berezovskyi/kistarfid/report/title.tex

\begin{titlepage}
\begin{center}
\setcounter{page}{0}
\Huge \doctitle\\[0.3cm]
\large \docauthor\\
\normalsize \today
\\[2cm]
%\Huge\color{red} DARFT
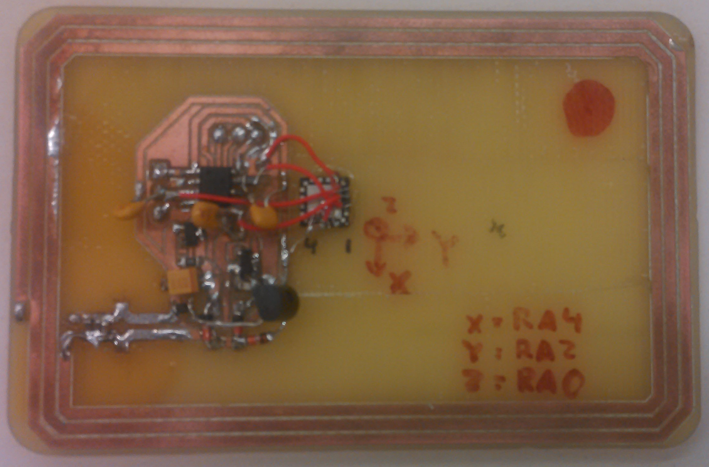
[picture p1: report/res/tag.jpg]

\end{center}
\end{titlepage}
\normalsize
