berezovskyi/kistarfid/report/work.tex

\section{Work Distribution}
\begin{table}[h]
\centering
\begin{tabular}{| l | r |}
	\hline
	Task & Assigned \\\hline
	CRC generation & Steven Arnow, Andrew Berezovskyi \\ \hline
	Demo client GUI and RFID interface conversion & Steven Arnow \\ \hline
	Demo client data processing & Axel Isaksson \\ \hline
	ADC interfacing & Steven Arnow \\\hline
	
	PCB schematic and layout & Axel Isaksson \\\hline
	Command decoding code & Axel Isaksson, Andrew Berezovskyi \\\hline
	Response encoding code & Axel Isaksson \\\hline
	
	Report & Steven Arnow, Axel Isaksson \\ \hline
	Staring at the spec, trying to make any sense of it & Steven, Axel, Andrew \\ \hline
	
	\hline
\end{tabular}
\caption{Work distribution}
\label{tab:work}
\end{table}
