berezovskyi/kistarfid/project_plan/slides.md

Slides outline
==================

##SW

* osc
	- bump freq
	- use
* VREF
* DAC
* COMP
* TIMER
* CCP
* STATE MACHINE
* CRC
	- other poly
* Modulation
