berezovskyi/kistarfid/minutes/160920.md

Project start
========================================

Parts:

- PIC12LF1612-E/SN
- GDEP015OC1

Links:

- http://www.instructables.com/id/RFID-Emulator-How-to-Clone-RFID-Card-Tag-/?ALLSTEPS
- http://www.openpcd.org/OpenPCD_Passive_RFID_Project
- https://github.com/dpavlin/librfid
- http://colinkarpfinger.com/blog/2010/the-dropouts-guide-to-antenna-design/
