berezovskyi/kistarfid/report/res/TX.pdf

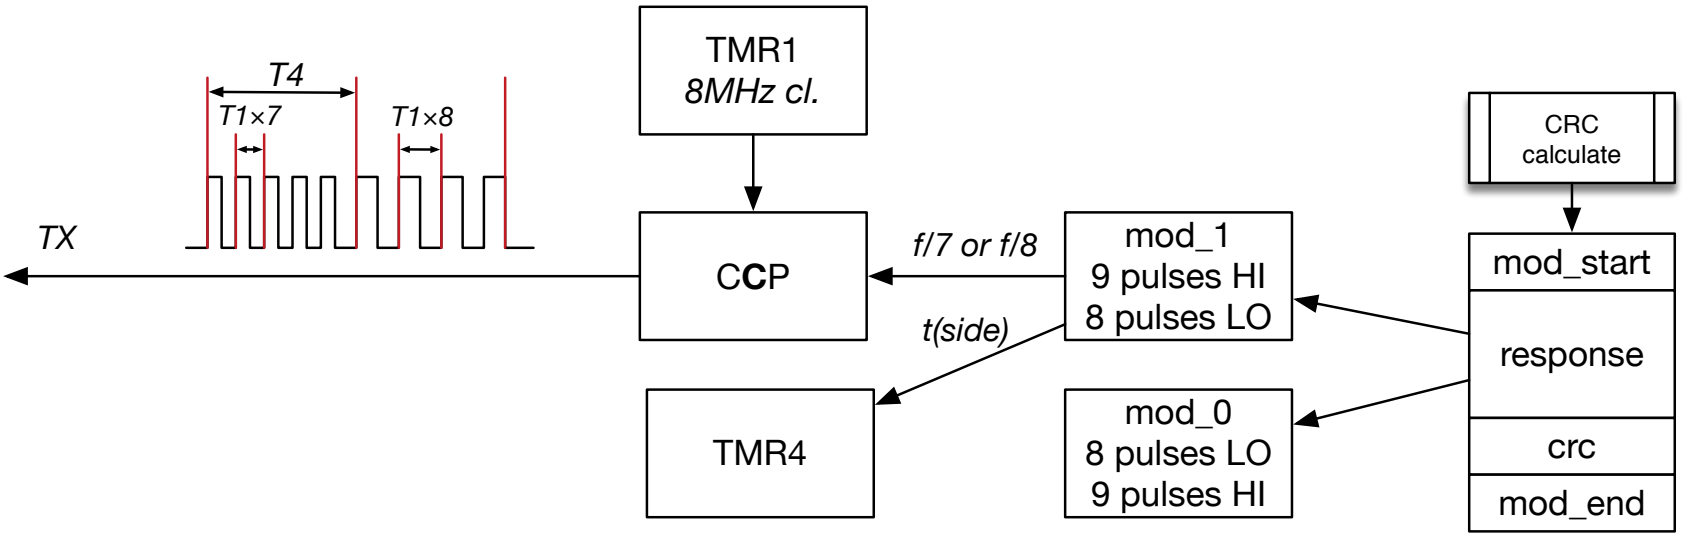
[picture p2: figure]
CRC calculate; mod_start; response; crc mod_end; mod_1 9 pulses HI 8 pulses LO; mod_0 8 pulses LO 9 pulses HI; TMR1 8MHz cl.; TMR4 CCP; t(side)
