berezovskyi/kistarfid/client/tag.png

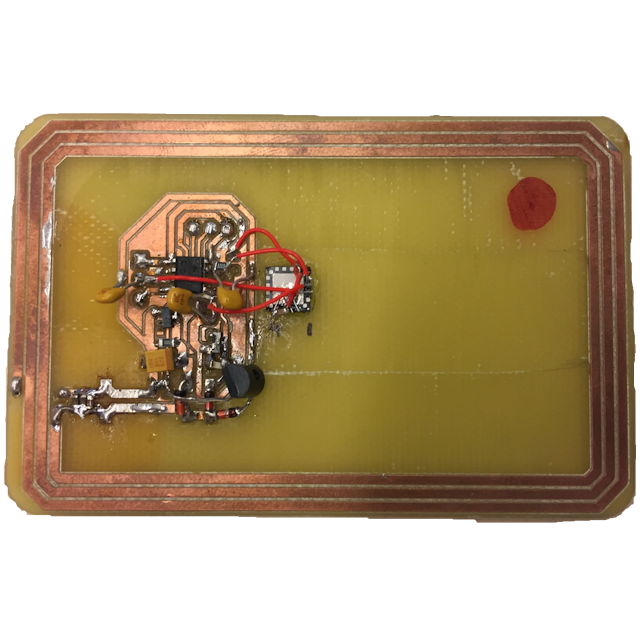
client/tag.png
