berezovskyi/kistarfid/report/res/RX.pdf

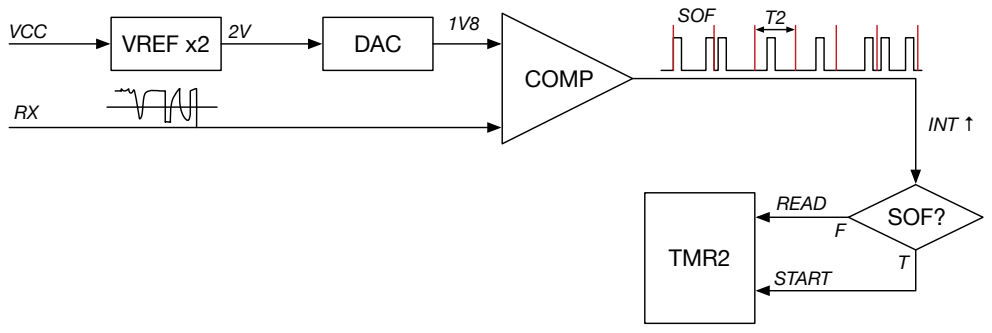
[picture p4: page 1]
VREF x2 VCC; DAC ²V; COMP; SOF?; SOF; TMR2; START; READ; INT
