berezovskyi/kistarfid/hw/softtag.kicad_pcb

## KiCad design hw/softtag.kicad_pcb (2016-10-04)

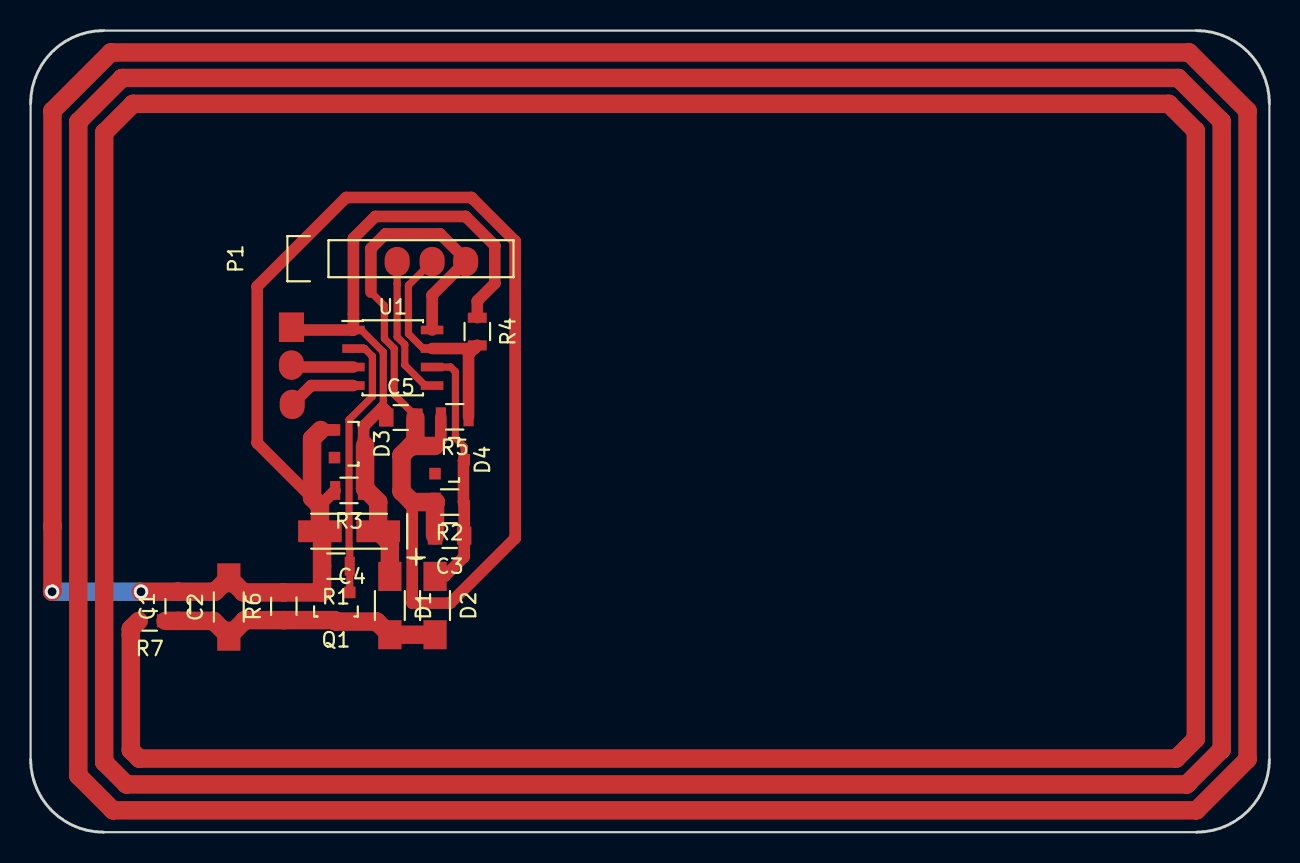
[picture p5: board softtag.kicad_pcb from above]

Board: 2 copper layers, 85.0 x 55.0 mm, 19 parts (0 on the bottom side), 9 nets.

Parts:
C1, C3, C5: C; C_0805
C2: CTRIM; C_1206_HandSoldering
C4: CP; TantalC_SizeA_EIA-3216_HandSoldering
D1: D_Schottky; C_1206_HandSoldering
D2: D; C_1206_HandSoldering
D3, D4: ZENER; SOT-23
P1: CONN_01X06; Pin_Header_Straight_1x06
Q1: Q_NMOS_GSD; SOT-23
R1, R2, R3, R4, R5, R6: R; R_0805
R7: 0R; R_0603
U1: PIC12LF1612-E/SN; SOIC-8_3.9x4.9mm_Pitch1.27mm

Connections:
/FREE0: P1.2, U1.3
/FREE1: P1.3, U1.4
/FREE2: P1.4, U1.5
/FREE3: P1.5, R4.2, R5.1, U1.7
/MOD_RX: C3.1, D2.1, D4.1, R2.1, U1.6
/MOD_TX: Q1.1, R1.1, U1.2
GND: C1.2, C2.2, C3.2, C4.2, C5.2, D3.2, D4.2, P1.6, Q1.2, R1.2, R2.2, R3.2, R5.2, R6.2, R7.2, U1.8
unnamed: C1.1, C2.1, D1.2, D2.2, Q1.3, R6.1, R7.1
VCC: C4.1, C5.1, D1.1, D3.1, P1.1, R3.1, R4.1, U1.1
