berezovskyi/kistarfid/sw/configuration_bits.c

/******************************************************************************/
/* Main Files to Include                                                      */
/******************************************************************************/

#if defined(__XC)
    #include <xc.h>         /* XC8 General Include File */
#elif defined(HI_TECH_C)
    #include <htc.h>        /* HiTech General Include File */
#endif

/******************************************************************************/
/* Configuration Bits                                                         */
/*                                                                            */
/* Refer to your Hi-Tech User Manual in the PICC installation directory       */
/* /doc folder for more information on filling in configuration bits.         */
/* In addition, configuration bit mnemonics can be found in your              */
/* PICC\version\include\<processor name>.h file for your device.  The XC8     */
/* compiler contains documentation on the configuration bit macros within     */
/* the compiler installation /docs folder in a file called                    */
/* pic18_chipinfo.html.                                                       */
/*                                                                            */
/* For additional information about what the hardware configurations mean in  */
/* terms of device operation, refer to the device datasheet.                  */
/*                                                                            */
/* A feature of MPLAB X is the 'Generate Source Code to Output' utility in    */
/* the Configuration Bits window.  Under Window > PIC Memory Views >          */
/* Configuration Bits, a user controllable configuration bits window is       */
/* available to Generate Configuration Bits source code which the user can    */
/* paste into this project.                                                   */
/*                                                                            */
/******************************************************************************/

/* TODO Fill in your config bits here.  Use the configuration bits generator. */


// PIC12LF1612 Configuration Bit Settings

// 'C' source line config statements

// CONFIG1
#pragma config FOSC = INTOSC    // Oscillator Selection Bits (INTOSC oscillator: I/O function on CLKIN pin)
#pragma config PWRTE = OFF      // Power-up Timer Enable (PWRT disabled)
#pragma config MCLRE = ON       // MCLR Pin Function Select (MCLR/VPP pin function is MCLR)
#pragma config CP = OFF         // Flash Program Memory Code Protection (Program memory code protection is disabled)
#pragma config BOREN = ON       // Brown-out Reset Enable (Brown-out Reset enabled)
#pragma config CLKOUTEN = ON    // Clock Out Enable (CLKOUT function is enabled on the CLKOUT pin)

// CONFIG2
#pragma config WRT = OFF        // Flash Memory Self-Write Protection (Write protection off)
#pragma config ZCD = OFF        // Zero Cross Detect Disable Bit (ZCD disable.  ZCD can be enabled by setting the ZCDSEN bit of ZCDCON)
#pragma config PLLEN = ON       // PLL Enable Bit (4x PLL is always enabled)
#pragma config STVREN = ON      // Stack Overflow/Underflow Reset Enable (Stack Overflow or Underflow will cause a Reset)
#pragma config BORV = LO        // Brown-out Reset Voltage Selection (Brown-out Reset Voltage (Vbor), low trip point selected.)
#pragma config LPBOR = OFF      // Low-Power Brown Out Reset (Low-Power BOR is disabled)
#pragma config LVP = ON         // Low-Voltage Programming Enable (Low-voltage programming enabled)

// CONFIG3
#pragma config WDTCPS = WDTCPS1F// WDT Period Select (Software Control (WDTPS))
#pragma config WDTE = OFF       // Watchdog Timer Enable (WDT disabled)
#pragma config WDTCWS = WDTCWSSW// WDT Window Select (Software WDT window size control (WDTWS bits))
#pragma config WDTCCS = SWC     // WDT Input Clock Selector (Software control, controlled by WDTCS bits)
