berezovskyi/kistarfid/sw/cmd.h

/* 
 * File:   cmd.h
 * Author: axel
 *
 * Created on October 26, 2016, 4:54 PM
 */

#ifndef CMD_H
#define	CMD_H

#ifdef	__cplusplus
extern "C" {
#endif

void cmd_inventory(void);
void cmd_read(void);


#ifdef	__cplusplus
}
#endif

#endif	/* CMD_H */
