berezovskyi/kistarfid/(commit log)

2016-10-04 rev A hardware
    [softtag.kicad_pcb, softtag.sch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]
2016-10-09 modulate start-of-frame and end-of-frame
2016-10-25 Update the schematic
    [softtag.sch]
2016-10-25 update schematic
    [softtag.sch]
2016-10-27 en liten fuling för accelerometern
2016-10-27 read command address => adc channel number
2016-10-28 non-working temperature sensor
2016-10-29 updated schematic
    [softtag.sch]
2016-10-29 added report friendly parts of the schematic
2016-10-30 report mod/demod circuit
2016-10-30 added schematics and block diagrams
2016-10-30 added inductor board layout
2016-10-30 mcu, accelerometer
